yakamasiinen/conical-tube-stand/stl/tube_stand_15mL.stl

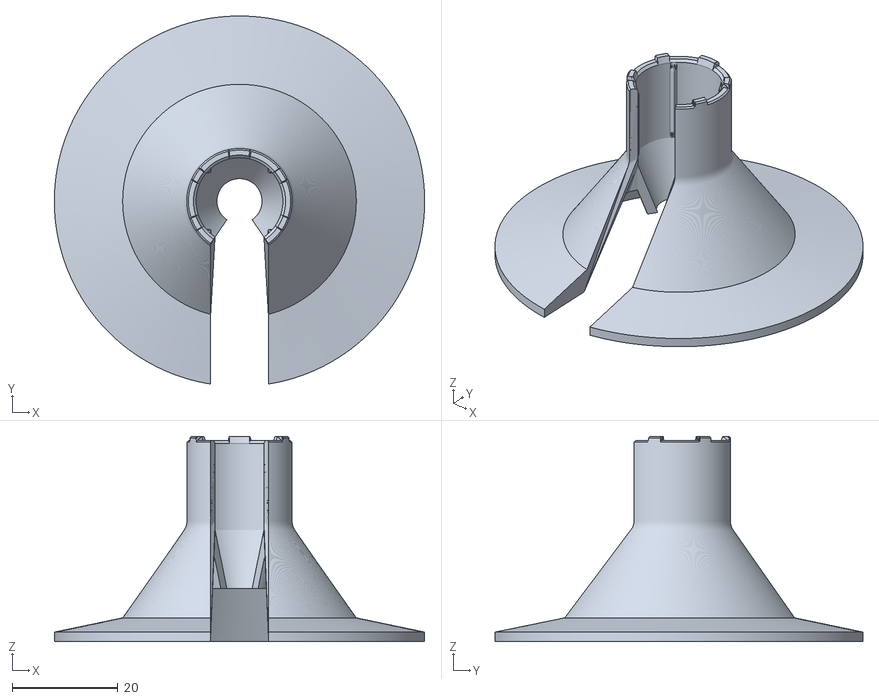
[picture p2: CAD file, 2026-10-12]
stl/tube_stand_15mL.stl
70.0 x 69.6 x 38.8
