yakamasiinen/conical-tube-stand/stl/tube_stand_50mL.stl

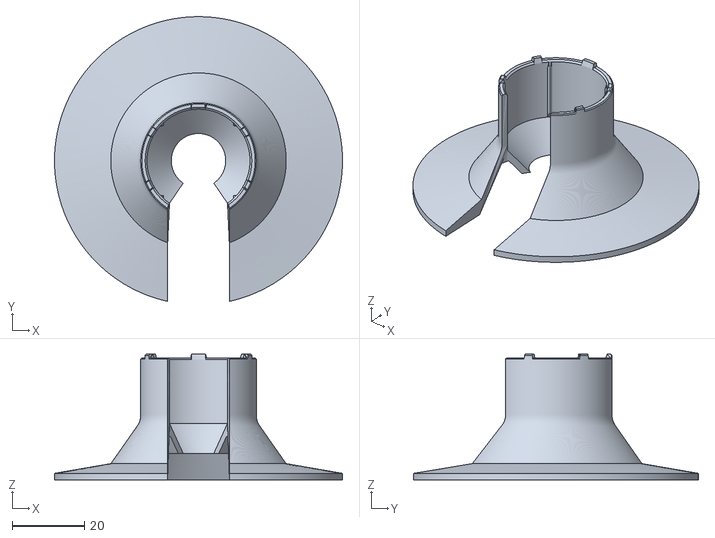
[picture p3: CAD file, 2026-10-12]
stl/tube_stand_50mL.stl
80.0 x 79.1 x 34.9
